ayrtonm/AVR-Logic-Analyzer/board.sch

## EAGLE design board.sch (2015-01-26)

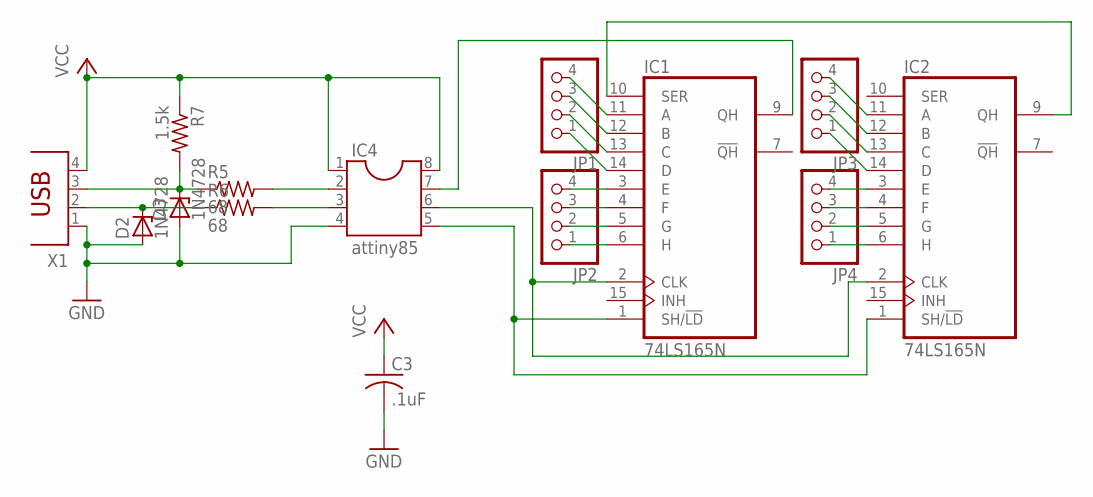
[picture p1: schematic board.sch]

Parts:
C3: .1uF; C025-024X044
D2, D3: 1N4728; DO41Z10
IC1, IC2: 74LS165N; DIL16
IC4: attiny85; SOCKET-08
JP1, JP2, JP3, JP4: PINHD-1X4; 1X04
R5, R6: 68; 0204/7
R7: 1.5k; 0204/7
X1: PN87520

Connections:
GND: C3.2, D2.A, D3.A, IC4.4, X1.1
unnamed: D2.C, R6.1, X1.2
unnamed: D3.C, R5.1, R7.2, X1.3
unnamed: IC4.2, R5.2
unnamed: IC4.3, R6.2
unnamed: IC1.2 (CLK), IC2.2 (CLK), IC4.6
unnamed: IC1.9 (QH), IC4.7
unnamed: IC1.1 (SH/!LD), IC2.1 (SH/!LD), IC4.5
unnamed: IC1.10 (SER), IC2.9 (QH)
unnamed: IC1.11 (A), JP1.4
unnamed: IC1.12 (B), JP1.3
unnamed: IC1.13 (C), JP1.2
unnamed: IC1.14 (D), JP1.1
unnamed: IC1.3 (E), JP2.4
unnamed: IC1.4 (F), JP2.3
unnamed: IC1.5 (G), JP2.2
unnamed: IC1.6 (H), JP2.1
unnamed: IC2.11 (A), JP3.4
unnamed: IC2.12 (B), JP3.3
unnamed: IC2.13 (C), JP3.2
unnamed: IC2.14 (D), JP3.1
unnamed: IC2.3 (E), JP4.4
unnamed: IC2.4 (F), JP4.3
unnamed: IC2.5 (G), JP4.2
unnamed: IC2.6 (H), JP4.1
VCC: C3.1, IC4.1, IC4.8, R7.1, X1.4
