ayrtonm/AVR-Logic-Analyzer/(commit log)

2015-01-19 Added draw.c and README
    draw.c currently draws and scrolls the values of 2 1-byte variables and includes the ability to change scrolling speed. Planning on adding more fine tuned control to speed change.
2015-01-21 USB is recognized
    fixed hardware issue(diode shorted out) that prevented usb from being recognized. can now transfer data reliably. host software moved to separate folder and added separate makefile. starting to integrate drawing functions into host software. only link that isn't working correctly seems to be the shift register code
    [draw.c, draw.h, host.c, main.c, shift.c]
2015-01-21 Added colors and updated makefile
    added colors for each set of 4 data lines. also removed printf statement in host.c
2015-01-21 debugging shift registers
    found and corrected one hardware error where 2 pins weren't connected. tried adding pullup resistor on input pin on attiny. also changed size scale in sdl
    [draw.h, host.c, shift.c]
2015-01-21 First working version
    hardware works perfectly. only thing with hardware is that pins on shift registers tend to float high when disconnected. also planning on fixing colors since they don't match the sets of 4 pins. also planning on adding more features like time scale and vertical lines to make it more visually appealing and cleaning up things like multiple typedefs for uint8 and multiple definitions and variables for delays. another serious thing that I need to investigate is minimum delay between parallel_in() and serial_out() and data transfer functions since this will determine the maximum frequency that can be measured reliably
    [host.c]
2015-01-21 Testing shorting delays and makefile optimizations for better performance
    [host.c, main.c, shift.c, usbconfig.h]
2015-01-25 First working version
    Finally done debugging. The problem turned out to be shorted diodes to ground on the data lines. This version can transfer and display data reliably with what I believe is the minimal delay possible with the attiny85. I'll add a schematic file for the setup, but this isn't important enough to have a pcb fabricated.
    [draw.h, host.c]
2015-01-25 Added vertical lines and more
    Added vertical lines to display fine tune control. still need to vertical lines to show timing and learn to use sdl_tff to write information and make this project useful. I should also make and add the schematic for the board
2015-01-26 Updated data rendering code
    updated draw.c in host software to make display more readable. For example, the screen no longer scrolls. Also need to change max and min delays and maybe add the ability to change delays on a logarithmic scale since there's a more notable difference when increasing time by orders of magnitude. also draw_delay is now the amount of time that a certain 'slide' is on the screen
    [draw.c, draw.h]
2015-01-26 Added board
    added schematic of hardware setup. I'm not planning on making this into a pcb, but it's nice to have the schematic. The schematic and code might differ in terms of which pins are used on the attiny85 (D+ and D- are switched and some shift register pins might be switched around).
    [board.sch]
2015-02-06 fixed inverted signals
    also added delay in main.c
    [draw.c, host.c]
